ianlee74/ReflowChateau/README.md

# Reflow Chateau
The Reflow Chateau is a set of mods created by Will Floyd-Jones to convert a toaster oven to a reflow oven.  These are my mods/improvements to his original design.

The original Reflow Chateau project can be found here:
http://www.willfj.com/reflow-chateau/
