ianlee74/ReflowChateau/BOM.xlsx

Device | Package | Part Number(s) | Quantity | Vendor | Vendor Pin | Unit Price | Ext Price
MAX6675 | SO08 | U3 | 1 | Digikey | MAX6675ISA+TCT-ND | $14.3300 | $14.33
S108T02 SSR | 4-SIP | U4, U5 | 2 | Digikey | 425-2396-5-ND | $5.1000 | $10.20
Screw Terminal | 3.50 mm pitch | JP2 | 1 | Digikey | ED1514-ND | $0.6800 | $0.68
Screw Terminal | 5.08 mm pitch | JP1 | 1 | Digikey | 281-1437-ND | $2.0400 | $2.04
0.8 A, 5V AC-DC Converter | Through hole | U2 | 1 | Digikey | 945-2164-5-ND | $15.0200 | $15.02
Teensy female headers | 14 position 0.1 " | U1 | 2 | Digikey | S7047-ND | $1.1800 | $2.36
Touchscreen female headers | 6 position 0.1 " | U6 | 1 | Digikey | S7039-ND | $0.7000 | $0.70
Touchscreen female headers | 8 position 0.1 " | U6 | 2 | Digikey | S7043-ND | $0.8400 | $1.68
Touchscreen female headers | 10 position 0.1 " | U6 | 1 | Digikey | S7041-ND | $0.8900 | $0.89
150 Ω Resistor | 0603 | R2, R6 | 25 | Digikey | 311-150GRCT-ND | $0.0072 | $0.18
330 Ω Resistor | 0603 | R1, R4, R8 | 25 | Digikey | 311-330GRCT-ND | $0.0072 | $0.18
470 Ω Resistor | 0603 | R3, R7 | 25 | Digikey | 311-470GRCT-ND | $0.0072 | $0.18
10k Ω Resistor | 0603 | R5, R9 | 25 | Digikey | 311-10KGRCT-ND | $0.0072 | $0.18
0.1 uF Capacitor | 0603 | C1 | 10 | Digikey | 490-1532-1-ND | $0.0190 | $0.19
MMBT3904 | SOT23-3 | Q1, Q2 | 2 | Digikey | MMBT3904TPMSCT-ND | $0.1400 | $0.28
Red LED | 1206 | LED1 | 1 | Digikey | 1516-1076-1-ND | $0.5200 | $0.52
Green LED | 1206 | LED2, LED3 | 2 | Digikey | 1516-1073-1-ND | $0.4700 | $0.94
Teensy 3.1 | NA | U1 | 1 | Adafruit | 1625 | $19.9500 | $19.95
K-Type Thermocouple | NA | NA | 1 | Adafruit | 270 | $9.9500 | $9.95
Capacitive Touchscreen | Arduino shield | U6 | 1 | Adafruit | 1947 | $44.9500 | $44.95
Digital Toaster | NA | NA | 1 | Sears | 00829294000P | $49.9900 | $49.99
3/8" 4-40 Machine Screw | NA | NA | 1 | Digikey | H781-ND | $0.0246 | $0.02 | * Min qty 100
PCB (2 layer, 10cm x 10cm) |  |  | 1 | DFRobot | http://www.dfrobot.com/index.php?route=product/product&path=135_134&product_id=718 | $5.0000 | $5.00
 |  |  |  |  |  | TOTAL | $180.41 | * Shipping not included
