ianlee74/ReflowChateau/OpenSCAD/plate.stl

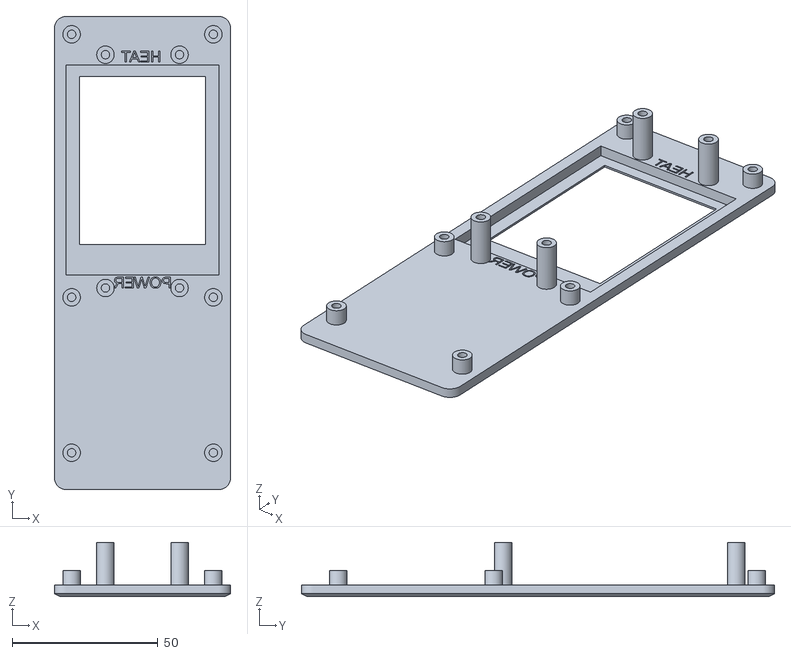
[picture p1: CAD file, 2015-04-25]
OpenSCAD/plate.stl
60.4 x 162.2 x 18.6
