ianlee74/ReflowChateau/OpenSCAD/plate.scad

$fn = 100;

width = 60.4;
length = 162.2;
thickness = 3;

screenWidth = 50.9;
screenLength = 70.6;

screwD = 2.9;

frameStandoffHorzSep = 48.6;
frameStandoffVert = [-68.5, -15.2, 75];

pcbStandoff = [[12.7, 0],
			  [-12.7, 0],
               [12.7, 80], 
			  [-12.7, 80]];

pcbStandoffY = -12;

rotate([0,180,0]) {
    difference(){
        translate([0, 0, 1.5])
        hull()
        {
            roundedCube([width, length, thickness], 4);
            translate([0, 0, 0.5])
            roundedCube([width-4, length-4, thickness+1], 2);
        }
        
        translate([0, 28.5, 0.9])
        lcd();
        //cube([screenWidth, screenLength, 6], center = true);

        for (i = frameStandoffVert){
            for (j = [-1, 1]){
                translate([j*frameStandoffHorzSep/2, i, 0])
                cylinder(r = screwD/2, h = 3);
            }
        }
        
        translate([-10.1, -12, thickness - 4.4])
        linear_extrude(5)
        text("POWER", 3.9);

        translate([-6.5, 65.5, thickness - 4.4])
        linear_extrude(5)
        text("HEAT", 3.9);
    }


    for (i = frameStandoffVert){
        for (j = [-1, 1]){
            translate([j*frameStandoffHorzSep/2, i, 0])
            standoff(6, 5);
        }
    }

    translate([0, pcbStandoffY, 0])
    for (i = pcbStandoff){
        translate(i)
        standoff(6, 14.6);
    }
}

rotate([0, 180, 0])
translate([0, 28.5, 1.1])
%lcd();

module standoff(diameter, height){
	translate([0, 0, -height])
	difference(){	
		cylinder(r = diameter/2, h = height);
        translate([0, 0, -0.1])
		cylinder(r = screwD/2, h = height + 0.1);
	}
}



module roundedCube(size, radius) {
  union()
  {
    cube(size - [2*radius,0,0], true);
    cube(size - [0,2*radius,0], true);
    for (x = [radius-size[0]/2, -radius+size[0]/2],
         y = [radius-size[1]/2, -radius+size[1]/2]) 
    {
        translate([x,y,0]) cylinder(r=radius, h=size[2], center=true);
    }
  }
}

module lcd()
{
    viewableW = 43.2;
    viewableL = 57.6;
    topBorder = 3.2;
    pad = .7;
    
    union()
    {
        //color("black") 
        cube([screenWidth + pad*2, screenLength + pad*2, 5], true);
    
        //color("white")
        translate([0, (screenLength-viewableL)/2-topBorder, 2])
        lcdViewable();
    }
}

module lcdViewable()
{
    cube([43.2, 57.6, 4], center=true);
}
