ianlee74/ReflowChateau/Eagle/Reflow Château.brd

## EAGLE design Eagle/Reflow Château.brd (2015-04-19)

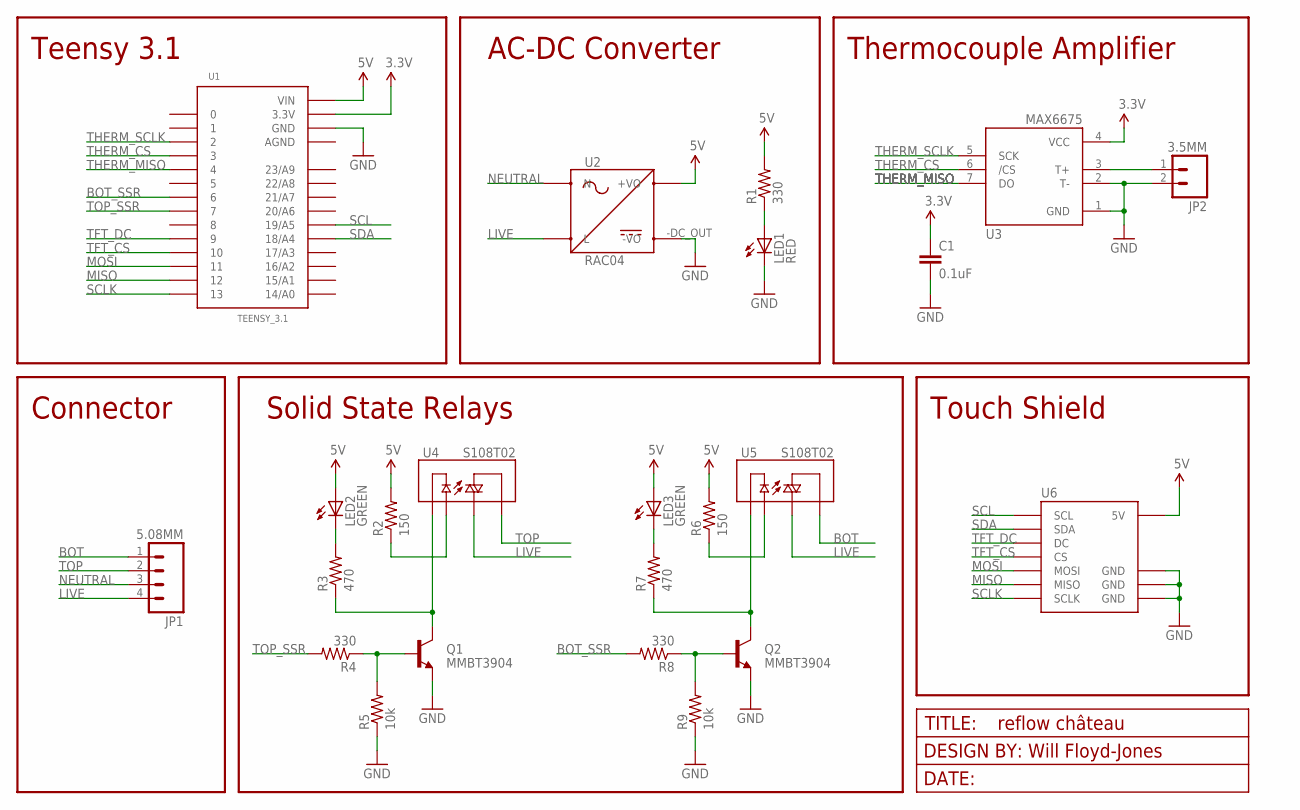
[picture p2: schematic Reflow Château.sch]

Parts:
C1: 0.1uF; 0603-CAP
JP1: 5.08MM; SCREWTERMINAL-5.08MM-4
JP2: 3.5MM; SCREWTERMINAL-3.5MM-2_LOCK
LED1: RED; LED-1206
LED2, LED3: GREEN; LED-1206
Q1, Q2: MMBT3904; SOT23-3
R1, R4, R8: 330; 0603-RES
R2, R6: 150; 0603-RES
R3, R7: 470; 0603-RES
R5, R9: 10k; 0603-RES
U1: TEENSY_3.1
U2: RAC04
U3: MAX6675; SO08
U4, U5: S108T02; RELAY-S108T02
U6: CAPACITIVE_TOUCH
U$9: FRAME; F-J_LOGO

Connections:
3.3V: C1.1, U1.3.3V, U3.4 (VCC)
5V: LED2.A, LED3.A, R1.2, R2.2, R6.2, U1.VIN, U2.+DC_OUT (+VO), U6.5V
AGND: U1.AGND
BOT: JP1.1, U5.1 (T1)
BOT_SSR: R8.2, U1.6
COIL: Q1.3 (C), R3.1, U4.4 (-)
COIL1: Q2.3 (C), R7.1, U5.4 (-)
GND: C1.2, JP2.2, LED1.C, Q1.2 (E), Q2.2 (E), R5.1, R9.1, U1.GND, U2.-DC_OUT (-VO), U3.1 (GND), U3.2 (T-), U6.GND, U6.GND@1 (GND), U6.GND@2 (GND)
LIVE: JP1.4, U2.LIVE (L), U4.2 (T2), U5.2 (T2)
MISO: U1.12, U6.D12 (MISO)
MOSI: U1.11, U6.D11 (MOSI)
unnamed: JP2.1, U3.3 (T+)
unnamed: R2.1, U4.3 (+)
unnamed: Q2.1 (B), R8.1, R9.2
unnamed: Q1.1 (B), R4.1, R5.2
unnamed: LED1.A, R1.1
unnamed: LED3.C, R7.2
unnamed: LED2.C, R3.2
unnamed: R6.1, U5.3 (+)
NEUTRAL: JP1.3, U2.NEUTRAL (N)
SCL: U1.19/A5, U6.SCL
SCLK: U1.13, U6.D13 (SCLK)
SDA: U1.18/A4, U6.SDA
TFT_CS: U1.10, U6.D10 (CS)
TFT_DC: U1.9, U6.D9 (DC)
THERM_CS: U1.3, U3.6 (/CS)
THERM_MISO: U1.4, U3.7 (DO)
THERM_SCLK: U1.2, U3.5 (SCK)
TOP: JP1.2, U4.1 (T1)
TOP_SSR: R4.2, U1.7

Notes on the sheet:
AC-DC Converter
Thermocouple Amplifier
Solid State Relays
Touch Shield
Connector
Teensy 3.1

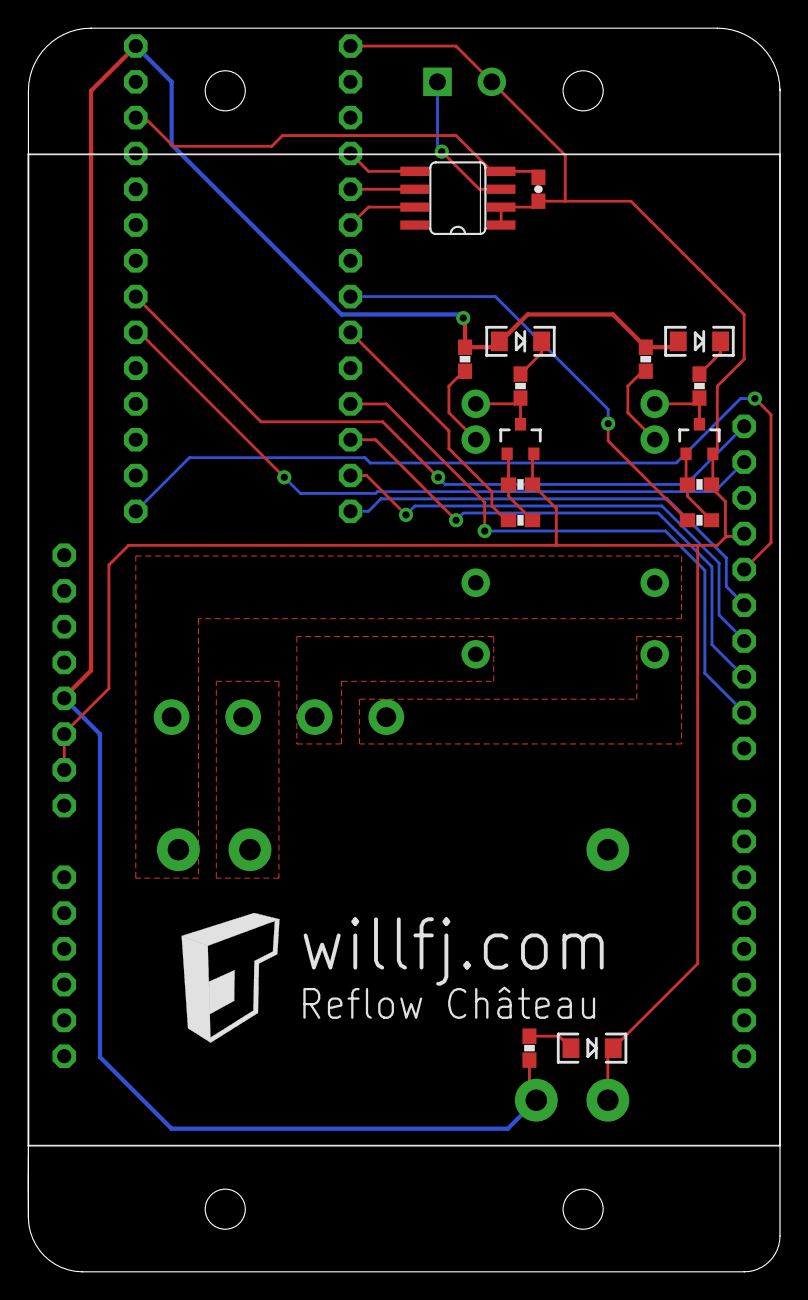
[picture p3: board Reflow Château.brd from above]

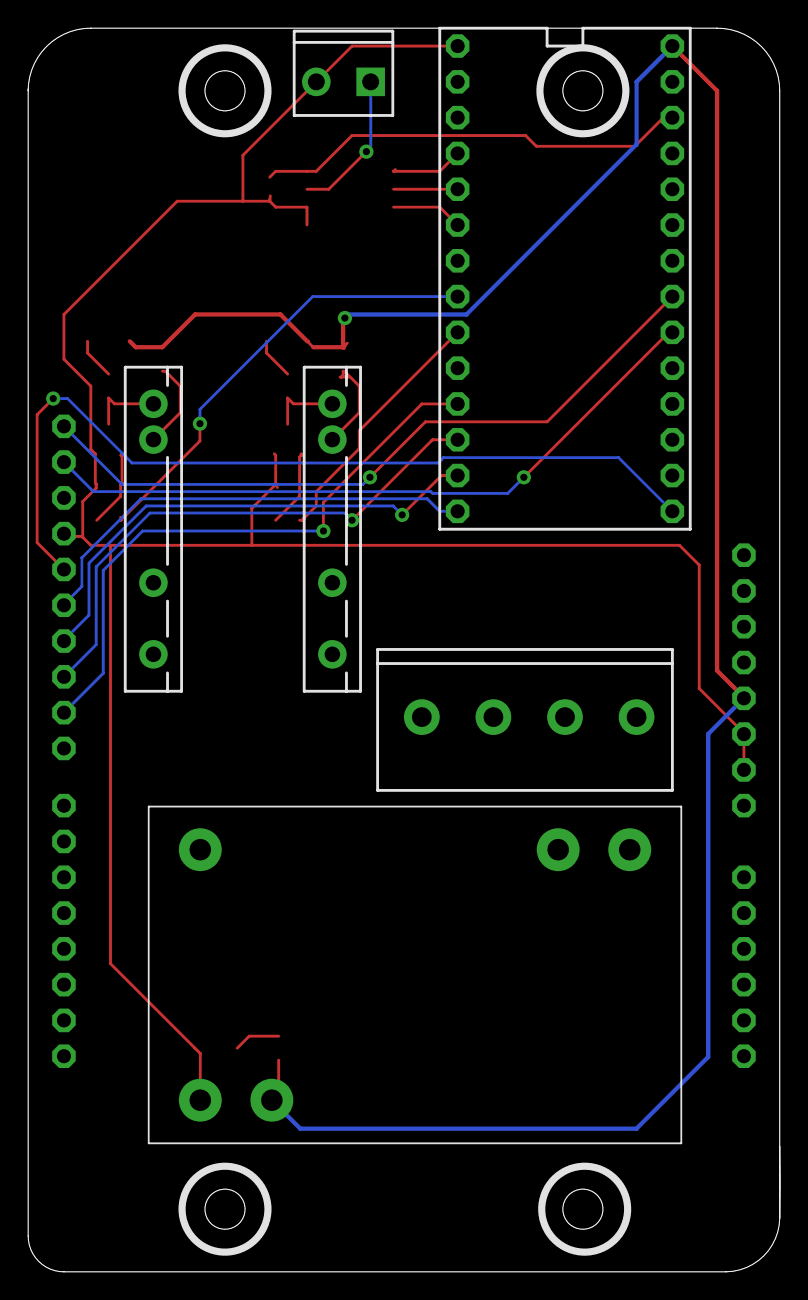
[picture p4: board Reflow Château.brd from below]

Board: 2 copper layers, 53.4 x 88.3 mm, 24 parts (6 on the bottom side), 29 nets.
