ianlee74/ReflowChateau/(commit log)

2015-04-19 Original files from Will-Floyd.
    [BOM.xlsx, Configuration.h, Reflow Château.brd, Reflow Château.sch, mountWasher.scad, plate.scad]
2015-04-20 Rotated plate for easy printing without rotating in printing software. Added 'Power' text.
    [plate.scad]
2015-04-21 Added LCD border cover and backlit text.
    [plate.scad, plate.stl]
2015-04-21 Increased size of text and increased thickness between text and front.
    [plate.scad, plate.stl]
2015-04-21 Added .7mm tolerance around the display to ease assembly.
    [plate.scad, plate.stl]
2015-04-23 Increased thickness of LCD frame.
    [plate.scad, plate.stl]
2015-04-25 Increased font size of text.
    [plate.scad, plate.stl]
